iley/ghostchess/pcb/v1/README.md

# Ghost Chess v1 PCB

## Spreadsheets

Use https://github.com/TheJigsApp/kicad-parts-placer-pcm

Run `./convert-spreadsheet.sh watch`

Edit `kicadpartsplacer-report.ods` in LibreOffice.
