iley/ghostchess/parts.ods

Part | Type | Count | Status | Comment | Link
0.1uF cap 1206 | Capacitor | 131 | ordered | 129 for main board, 2 for brains
10uF cap 1206 | Capacitor | 2 | done
100uF 1206 | Capacitor | 1 | done
22pF 1206 | Capacitor | 2 | done
330 ohm 1206 | Resistor | 1 | done
10k ohm 1206 | Resistor | 10 | done | 8 for main board, 2 for brains
WS2812B | LED | 64 | done
DRV5033A | Sensor | 64 | done
SMBJ5.6A | Diode | 1 | ordered
MF-LSMF600 | Fuse | 1 | done
2N7002 | MOSFET | 8 | ordered
SS11-BBIWJ-R30-R | Switch | 1 | done | main power switch
AMS1117-3.3 | Linear regulator | 1 | ordered | 3.3v linear regulator
11.0592MHz HC49 | Crystal | 1 | ordered
12mm pushbutton | Pushbutton | 3 | done
Atmega 644p | MCU | 1 | done
ISP socket right-angle | Socket | 1 | done
DIP 40 socket | Socket | 1 | done
WC1602A | Screen | 1 | done |  | https://www.aliexpress.com/item/1005006034531826.html
