iley/ghostchess/pcb/proto/ghostchess_proto.step

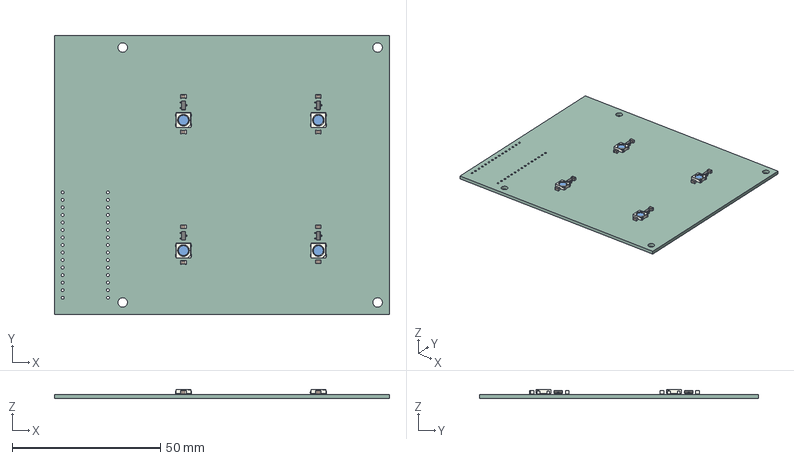
[picture p1: CAD file, 2026-04-05]
pcb/proto/ghostchess_proto.step
113.0 x 94.0 x 3.20 mm
C_0805_2012Metric x 8
SOT-23 x 4
LED_WS2812B_PLCC4_5.0x5.0mm_P3.2mm x 4
ghostchess_proto_PCB
