iley/ghostchess/(list of files, cad)

Other CAD files:
pcb/proto/autochess_proto.step
