iley/ghostchess/pcb/ghostchess_brains_v1/ghostchess_brains_v1.kicad_pcb

## KiCad design pcb/ghostchess_brains_v1/ghostchess_brains_v1.kicad_pcb (2026-08-10)

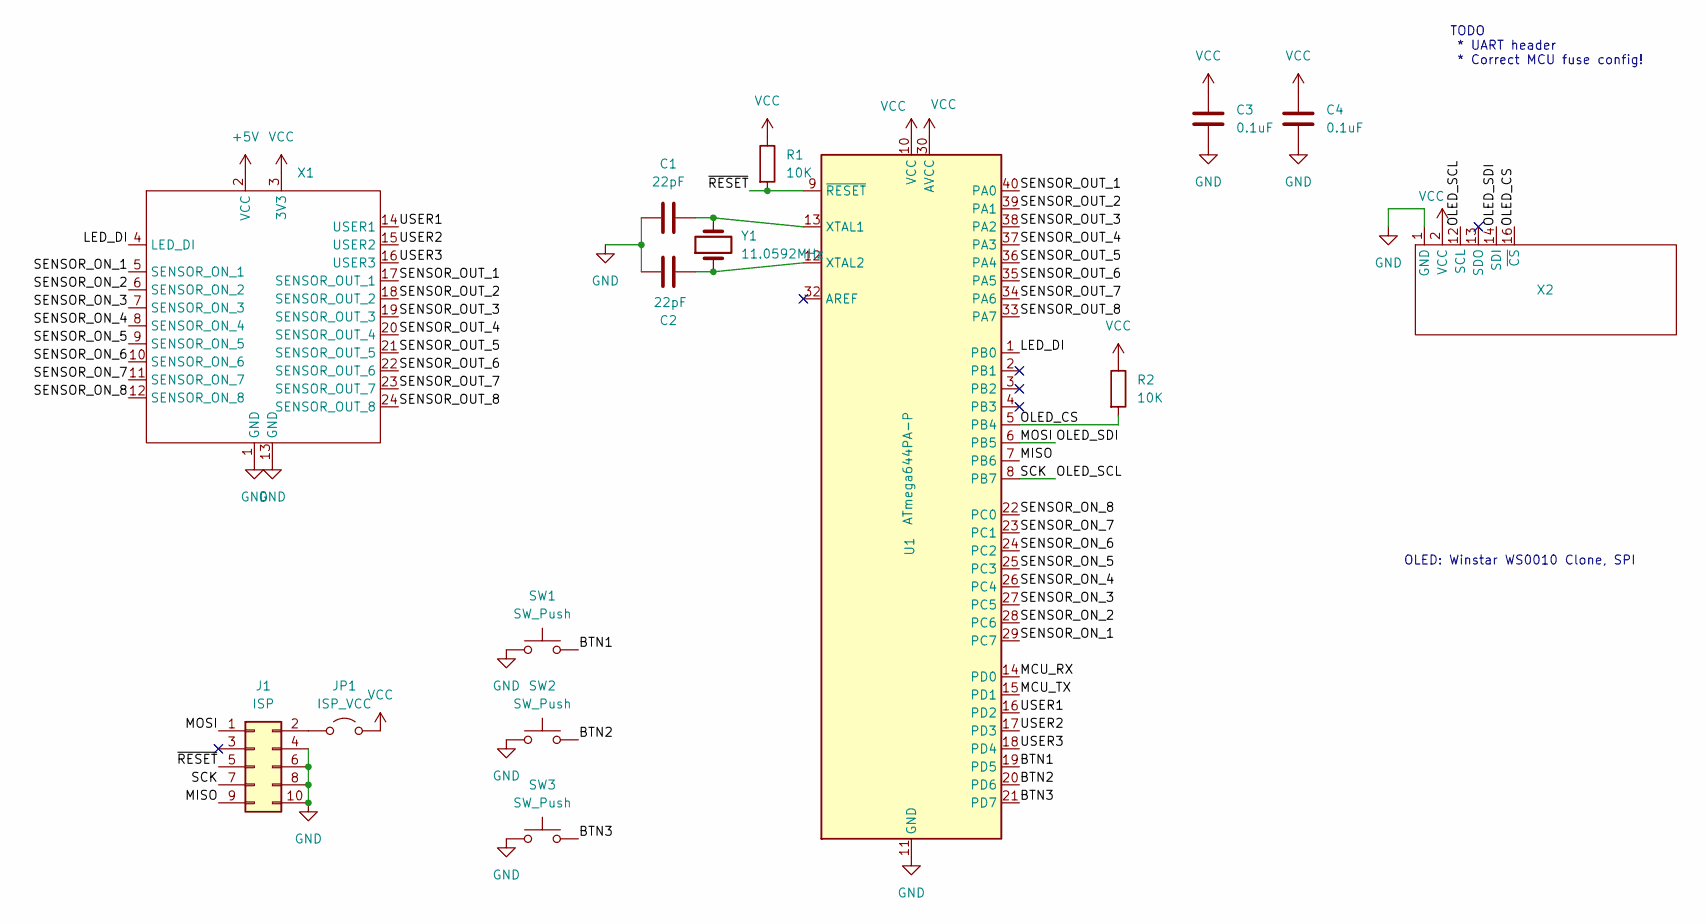
[picture p2: schematic ghostchess_brains_v1.kicad_sch]

Parts:
C1, C2: 22pF; C_1206_3216Metric_Pad1.33x1.80mm_HandSolder
C3, C4: 0.1uF; C_1206_3216Metric_Pad1.33x1.80mm_HandSolder
J1: ISP; IDC-Header_2x05_P2.54mm_Horizontal
JP1: ISP_VCC; PinHeader_1x02_P2.54mm_Vertical
R1, R2: 10K; C_1206_3216Metric_Pad1.33x1.80mm_HandSolder
SW1, SW2, SW3: SW_Push; SW_PUSH-12mm
U1: ATmega644PA-P; DIP-40_W15.24mm
X1: GhostChess_Daughter_Board
X2: WC1602A_3Hole
Y1: 11.0592MHz; Crystal_HC49-U_Vertical

Connections:
+5V: X1.2 (VCC)
/BTN1: SW1.2, U1.19 (PD5)
/BTN2: SW2.2, U1.20 (PD6)
/BTN3: SW3.2, U1.21 (PD7)
/LED_DI: U1.1 (PB0), X1.4 (LED_DI)
/MCU_RX: U1.14 (PD0)
/MCU_TX: U1.15 (PD1)
/MISO: J1.9, U1.7 (PB6)
/MOSI: J1.1, U1.6 (PB5), X2.14 (SDI)
/OLED_CS: R2.2, U1.5 (PB4), X2.16 (~CS)
/OLED_SCL: J1.7, U1.8 (PB7), X2.12 (SCL)
/SENSOR_ON_1: U1.29 (PC7), X1.5 (SENSOR_ON_1)
/SENSOR_ON_2: U1.28 (PC6), X1.6 (SENSOR_ON_2)
/SENSOR_ON_3: U1.27 (PC5), X1.7 (SENSOR_ON_3)
/SENSOR_ON_4: U1.26 (PC4), X1.8 (SENSOR_ON_4)
/SENSOR_ON_5: U1.25 (PC3), X1.9 (SENSOR_ON_5)
/SENSOR_ON_6: U1.24 (PC2), X1.10 (SENSOR_ON_6)
/SENSOR_ON_7: U1.23 (PC1), X1.11 (SENSOR_ON_7)
/SENSOR_ON_8: U1.22 (PC0), X1.12 (SENSOR_ON_8)
/SENSOR_OUT_1: U1.40 (PA0), X1.17 (SENSOR_OUT_1)
/SENSOR_OUT_2: U1.39 (PA1), X1.18 (SENSOR_OUT_2)
/SENSOR_OUT_3: U1.38 (PA2), X1.19 (SENSOR_OUT_3)
/SENSOR_OUT_4: U1.37 (PA3), X1.20 (SENSOR_OUT_4)
/SENSOR_OUT_5: U1.36 (PA4), X1.21 (SENSOR_OUT_5)
/SENSOR_OUT_6: U1.35 (PA5), X1.22 (SENSOR_OUT_6)
/SENSOR_OUT_7: U1.34 (PA6), X1.23 (SENSOR_OUT_7)
/SENSOR_OUT_8: U1.33 (PA7), X1.24 (SENSOR_OUT_8)
/USER1: U1.16 (PD2), X1.14 (USER1)
/USER2: U1.17 (PD3), X1.15 (USER2)
/USER3: U1.18 (PD4), X1.16 (USER3)
/~RESET: J1.5, R1.2, U1.9 (~RESET)
GND: C1.1, C2.1, C3.2, C4.2, J1.4, J1.6, J1.8, J1.10, SW1.1, SW2.1, SW3.1, U1.11 (GND), U1.31 (GND), X1.1 (GND), X1.13 (GND), X2.1 (GND)
unnamed: J1.2, JP1.1 (A)
unnamed: C1.2, U1.13 (XTAL1), Y1.2
unnamed: C2.2, U1.12 (XTAL2), Y1.1
VCC: C3.1, C4.1, JP1.2 (B), R1.1, R2.1, U1.10 (VCC), U1.30 (AVCC), X1.3 (3V3), X2.2 (VCC)

Notes on the sheet:
OLED: Winstar WS0010 Clone, SPI
TODO * UART header * Correct MCU fuse config!

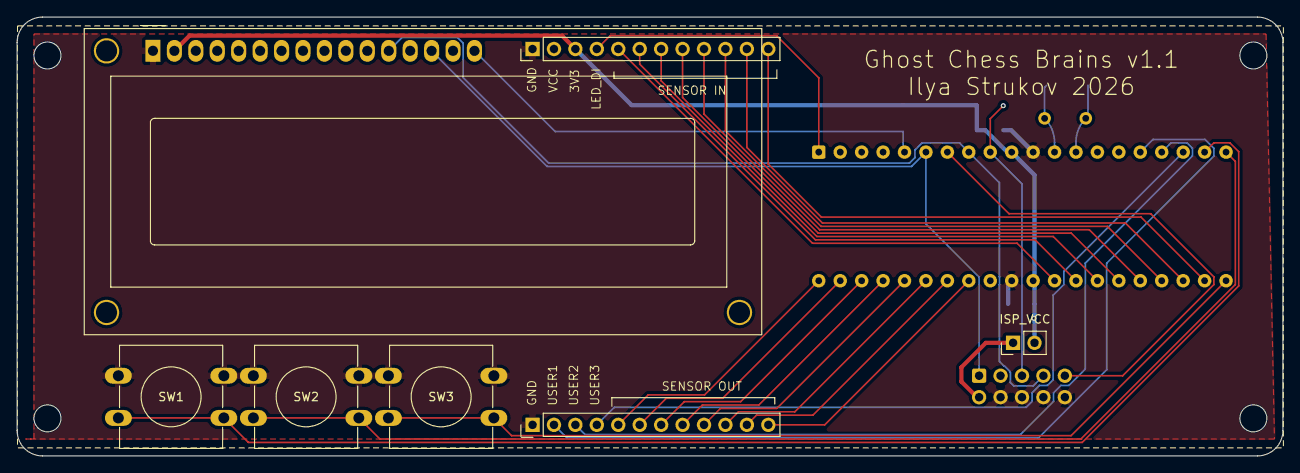
[picture p3: board ghostchess_brains_v1.kicad_pcb from above]

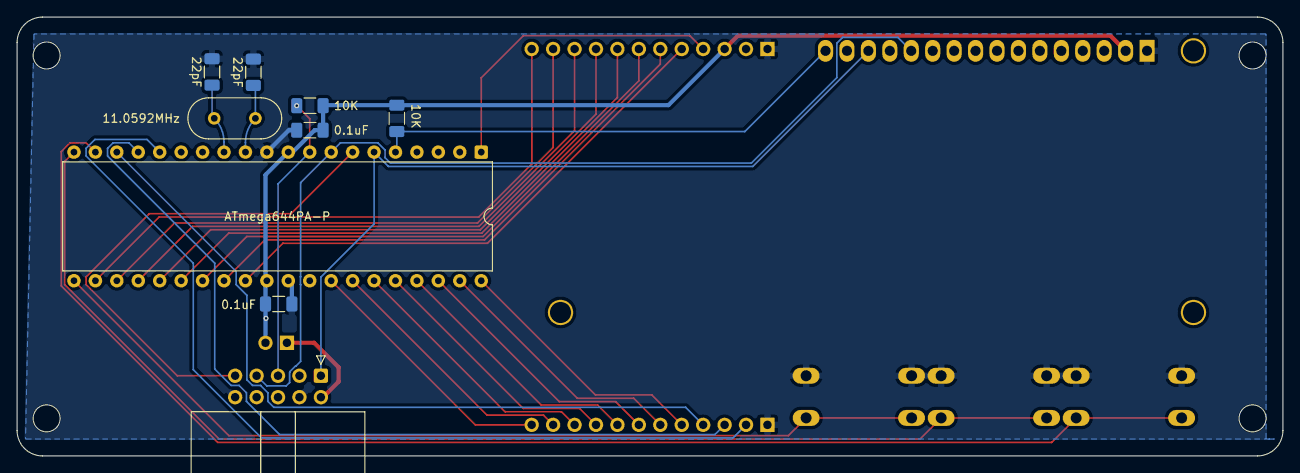
[picture p4: board ghostchess_brains_v1.kicad_pcb from below]

Board: 2 copper layers, 150.0 x 52.0 mm, 15 parts (9 on the bottom side), 33 nets.
