iley/ghostchess/pcb/v1/ghostchess_v1.kicad_pcb

## KiCad design pcb/v1/ghostchess_v1.kicad_pcb (2026-05-30)

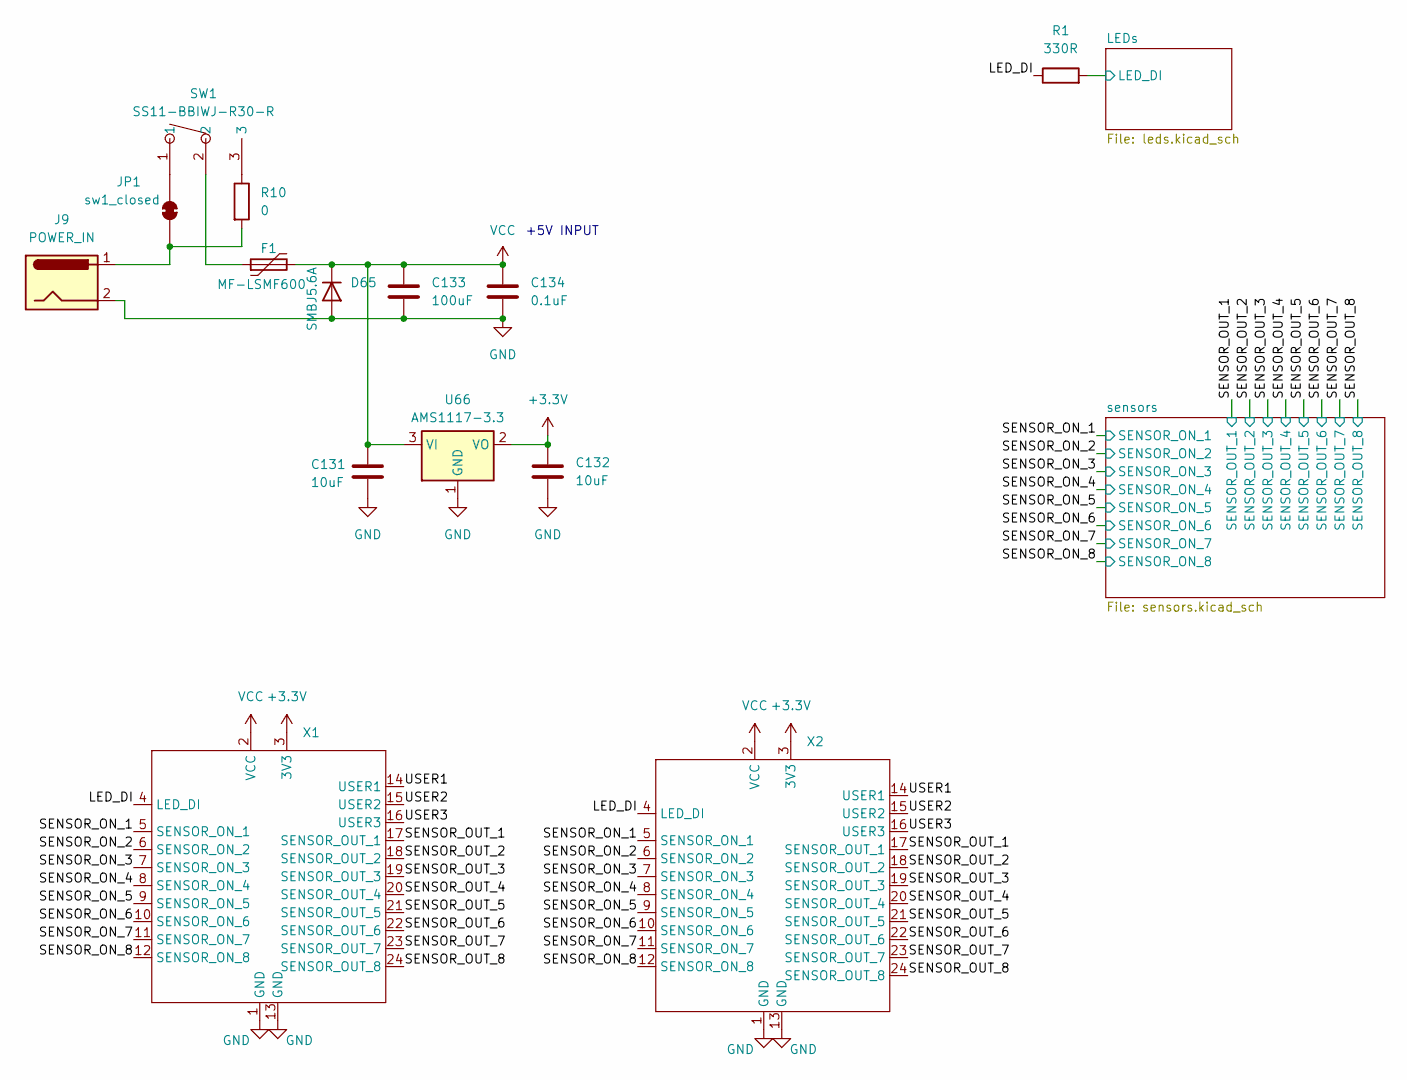
[picture p5: schematic ghostchess_v1.kicad_sch]

Parts:
C131, C132: 10uF; C_1206_3216Metric_Pad1.33x1.80mm_HandSolder
C133: 100uF; C_1206_3216Metric_Pad1.33x1.80mm_HandSolder
C134: 0.1uF; C_1206_3216Metric_Pad1.33x1.80mm_HandSolder
D65: SMBJ5.6A; D_SMB_Handsoldering
F1: MF-LSMF600; Fuse_2920_7451Metric_Pad2.10x5.45mm_HandSolder
J9: POWER_IN; BarrelJack_Horizontal
JP1: sw1_closed; SolderJumper-2_P1.3mm_Bridged_Pad1.0x1.5mm
R1: 330R; R_1206_3216Metric_Pad1.30x1.75mm_HandSolder
R10: 0; R_1206_3216Metric_Pad1.30x1.75mm_HandSolder
SW1: SS11-BBIWJ-R30-R; SW-TH_SS11-BBIWJ-R30-R; LCSC Part C309071
U66: AMS1117-3.3; SOT-223-3_TabPin2
X1, X2: GhostChess_Daughter_Board

Connections:
+3.3V: C132.1, U66.2 (VO), X1.3 (3V3), X2.3 (3V3); also elsewhere on the board
/LED_DI: R1.1, X1.4 (LED_DI), X2.4 (LED_DI)
/LEDs/LED_DI: R1.2; also elsewhere on the board
/SENSOR_ON_1: X1.5 (SENSOR_ON_1), X2.5 (SENSOR_ON_1); also elsewhere on the board
/SENSOR_ON_2: X1.6 (SENSOR_ON_2), X2.6 (SENSOR_ON_2); also elsewhere on the board
/SENSOR_ON_3: X1.7 (SENSOR_ON_3), X2.7 (SENSOR_ON_3); also elsewhere on the board
/SENSOR_ON_4: X1.8 (SENSOR_ON_4), X2.8 (SENSOR_ON_4); also elsewhere on the board
/SENSOR_ON_5: X1.9 (SENSOR_ON_5), X2.9 (SENSOR_ON_5); also elsewhere on the board
/SENSOR_ON_6: X1.10 (SENSOR_ON_6), X2.10 (SENSOR_ON_6); also elsewhere on the board
/SENSOR_ON_7: X1.11 (SENSOR_ON_7), X2.11 (SENSOR_ON_7); also elsewhere on the board
/SENSOR_ON_8: X1.12 (SENSOR_ON_8), X2.12 (SENSOR_ON_8); also elsewhere on the board
/SENSOR_OUT_1: X1.17 (SENSOR_OUT_1), X2.17 (SENSOR_OUT_1); also elsewhere on the board
/SENSOR_OUT_2: X1.18 (SENSOR_OUT_2), X2.18 (SENSOR_OUT_2); also elsewhere on the board
/SENSOR_OUT_3: X1.19 (SENSOR_OUT_3), X2.19 (SENSOR_OUT_3); also elsewhere on the board
/SENSOR_OUT_4: X1.20 (SENSOR_OUT_4), X2.20 (SENSOR_OUT_4); also elsewhere on the board
/SENSOR_OUT_5: X1.21 (SENSOR_OUT_5), X2.21 (SENSOR_OUT_5); also elsewhere on the board
/SENSOR_OUT_6: X1.22 (SENSOR_OUT_6), X2.22 (SENSOR_OUT_6); also elsewhere on the board
/SENSOR_OUT_7: X1.23 (SENSOR_OUT_7), X2.23 (SENSOR_OUT_7); also elsewhere on the board
/SENSOR_OUT_8: X1.24 (SENSOR_OUT_8), X2.24 (SENSOR_OUT_8); also elsewhere on the board
/USER1: X1.14 (USER1), X2.14 (USER1)
/USER2: X1.15 (USER2), X2.15 (USER2)
/USER3: X1.16 (USER3), X2.16 (USER3)
GND: C131.2, C132.2, C133.2, C134.2, D65.2 (A), J9.2, U66.1 (GND), X1.1 (GND), X1.13 (GND), X2.1 (GND), X2.13 (GND); also elsewhere on the board
unnamed: F1.1, SW1.2
unnamed: J9.1, JP1.1 (A), R10.2
unnamed: JP1.2 (B), SW1.1
unnamed: R10.1, SW1.3
VCC: C131.1, C133.1, C134.1, D65.1 (K), F1.2, U66.3 (VI), X1.2 (VCC), X2.2 (VCC); also elsewhere on the board

Notes on the sheet:
+5V INPUT

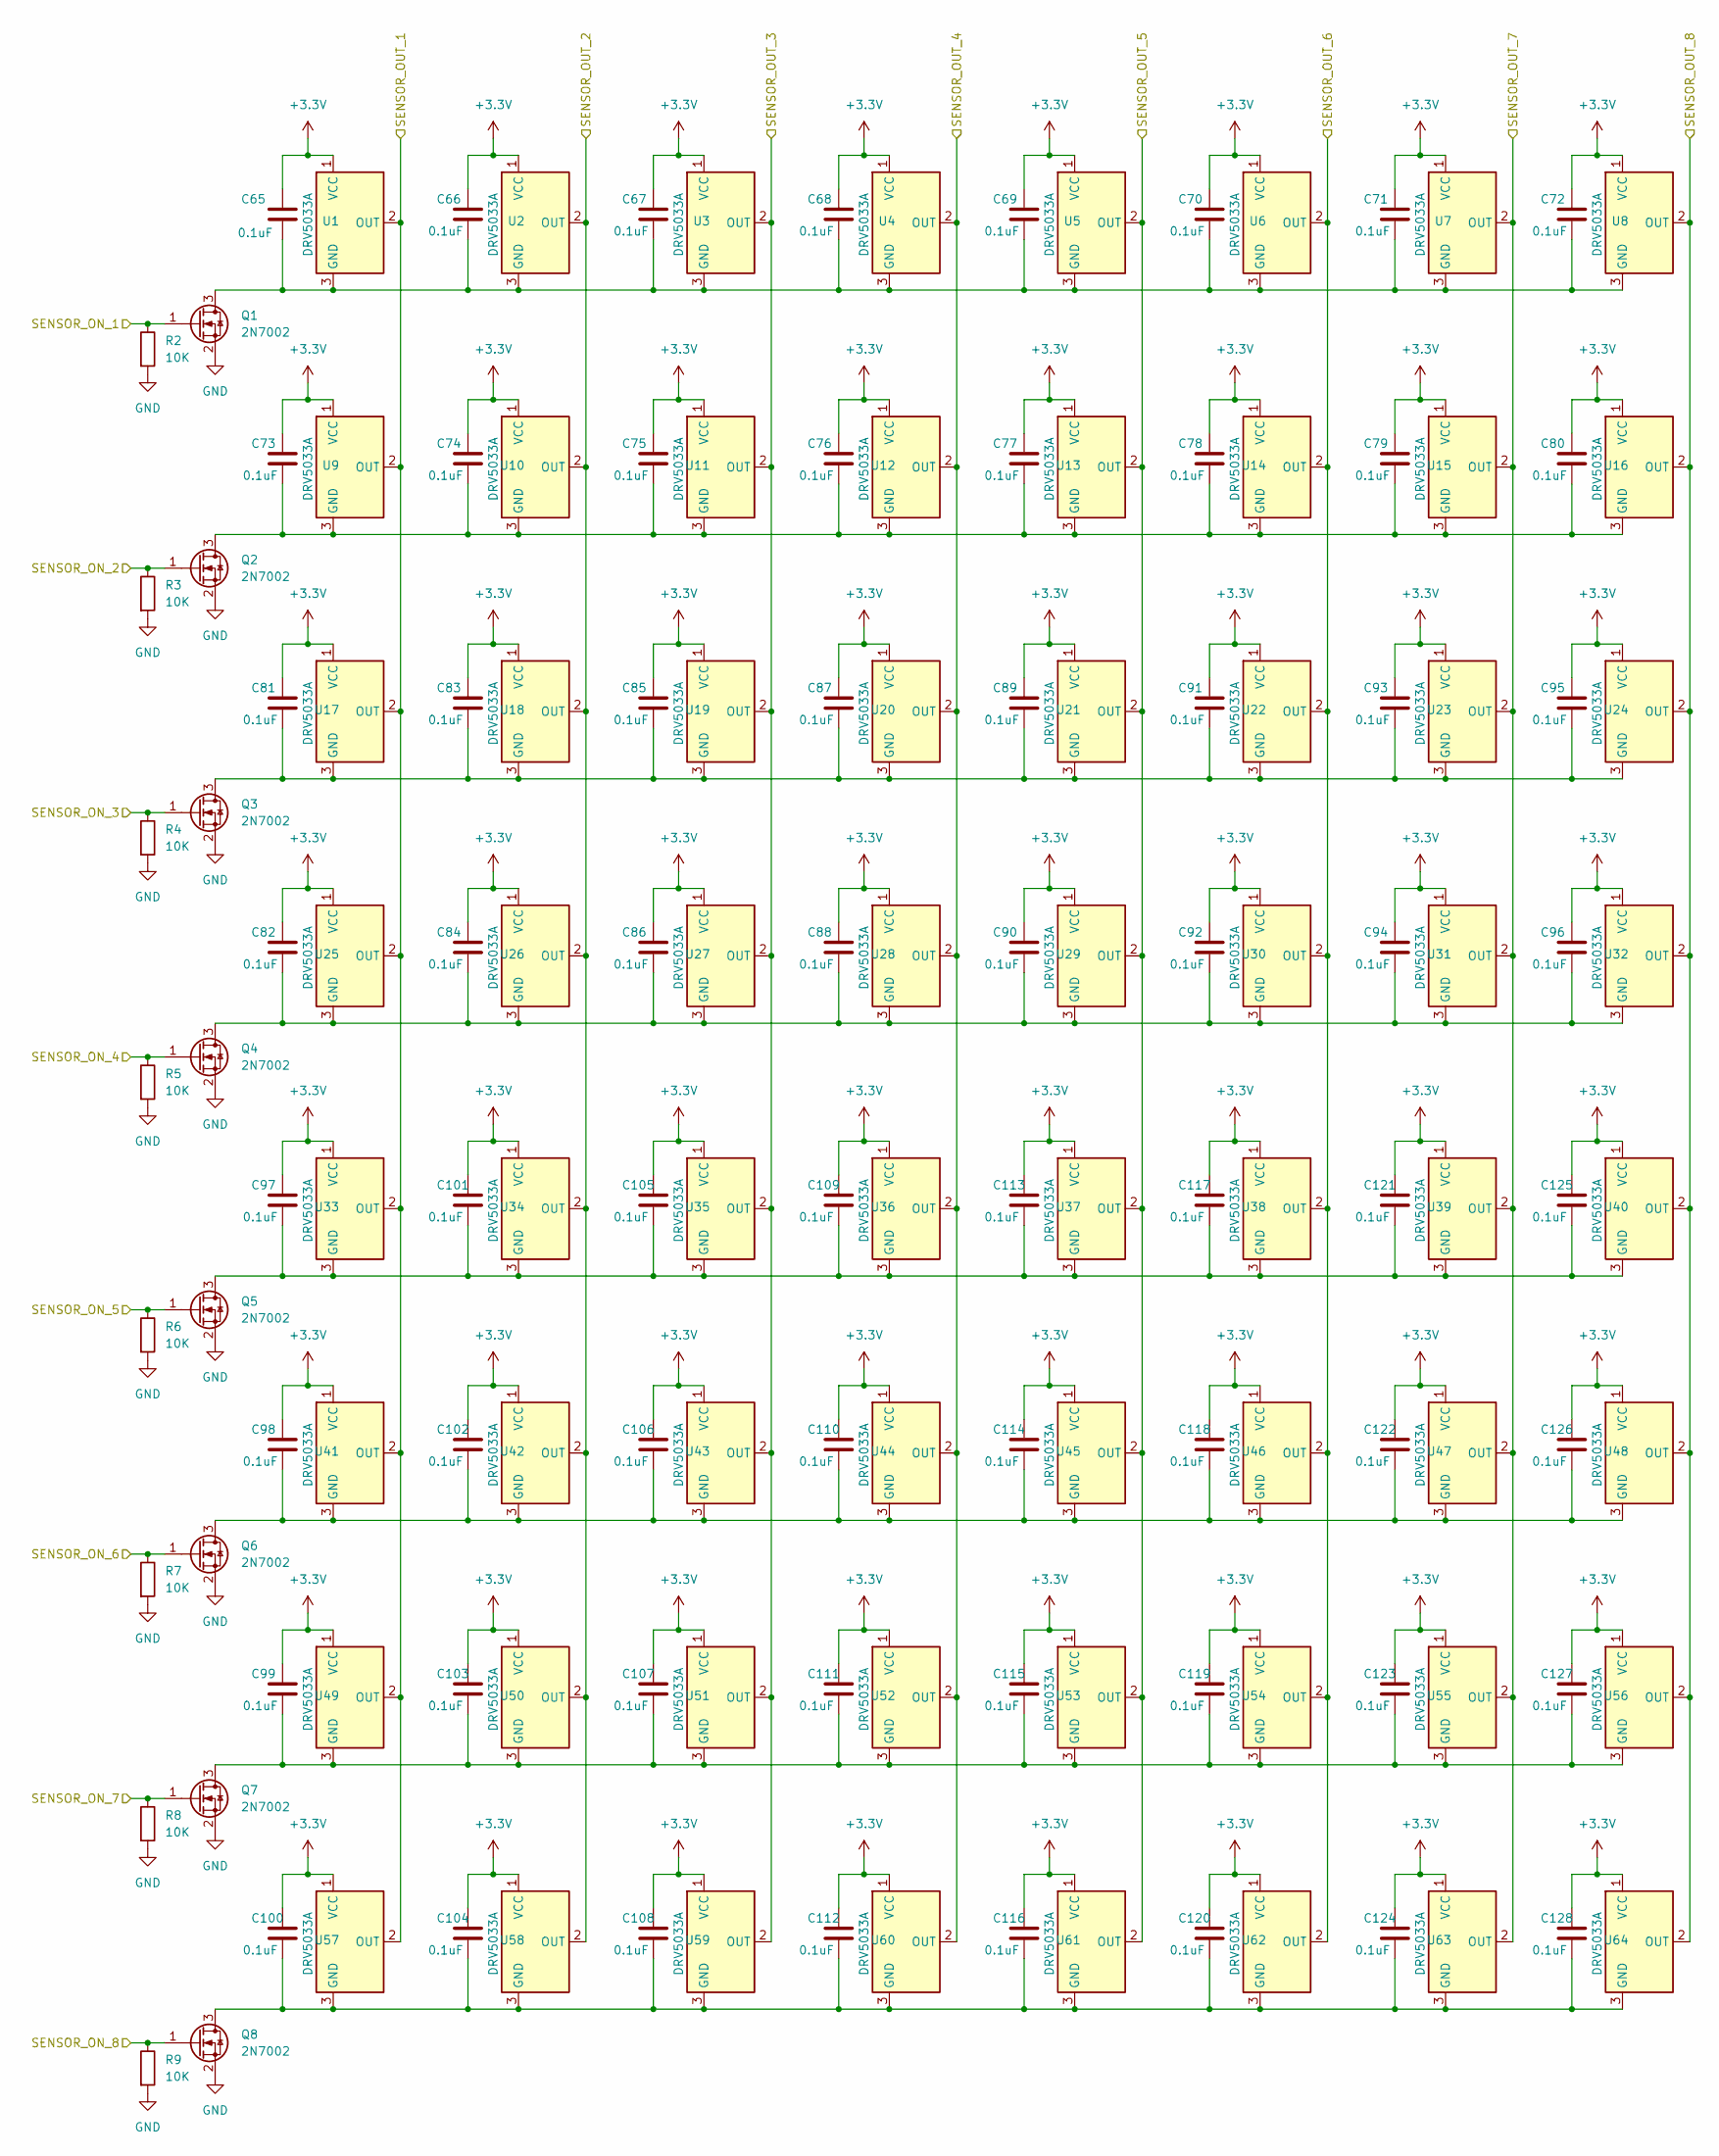
[picture p6: schematic sensors.kicad_sch]

Parts:
C65, C66, C67, C68, C69, C70, C71, C72, C73, C74, C75, C76, C77, C78, C79, C80, C81, C82, C83, C84, C85, C86, C87, C88, C89, C90, C91, C92, C93, C94, C95, C96, C97, C98, C99, C100, C101, C102, C103, C104, C105, C106, C107, C108, C109, C110, C111, C112, C113, C114, C115, C116, C117, C118, C119, C120, C121, C122, C123, C124, C125, C126, C127, C128: 0.1uF; C_1206_3216Metric_Pad1.33x1.80mm_HandSolder
Q1, Q2, Q3, Q4, Q5, Q6, Q7, Q8: 2N7002; SOT-23
R2, R3, R4, R5, R6, R7, R8, R9: 10K; R_1206_3216Metric_Pad1.30x1.75mm_HandSolder
U1, U2, U3, U4, U5, U6, U7, U8, U9, U10, U11, U12, U13, U14, U15, U16, U17, U18, U19, U20, U21, U22, U23, U24, U25, U26, U27, U28, U29, U30, U31, U32, U33, U34, U35, U36, U37, U38, U39, U40, U41, U42, U43, U44, U45, U46, U47, U48, U49, U50, U51, U52, U53, U54, U55, U56, U57, U58, U59, U60, U61, U62, U63, U64: DRV5033A; SOT-23

Connections:
+3.3V: C65.2, C66.1, C67.1, C68.1, C69.1, C70.1, C71.1, C72.1, C73.1, C74.1, C75.1, C76.1, C77.1, C78.1, C79.1, C80.1, C81.1, C82.1, C83.1, C84.1, C85.1, C86.1, C87.1, C88.1, C89.1, C90.1, C91.1, C92.1, C93.1, C94.1, C95.1, C96.1, C97.1, C98.1, C99.1, C100.1, C101.1, C102.1, C103.1, C104.1, C105.1, C106.1, C107.1, C108.1, C109.1, C110.1, C111.1, C112.1, C113.1, C114.1, C115.1, C116.1, C117.1, C118.1, C119.1, C120.1, C121.1, C122.1, C123.1, C124.1, C125.1, C126.1, C127.1, C128.1, U1.1 (VCC), U2.1 (VCC), U3.1 (VCC), U4.1 (VCC), U5.1 (VCC), U6.1 (VCC), U7.1 (VCC), U8.1 (VCC), U9.1 (VCC), U10.1 (VCC), U11.1 (VCC), U12.1 (VCC), U13.1 (VCC), U14.1 (VCC), U15.1 (VCC), U16.1 (VCC), U17.1 (VCC), U18.1 (VCC), U19.1 (VCC), U20.1 (VCC), U21.1 (VCC), U22.1 (VCC), U23.1 (VCC), U24.1 (VCC), U25.1 (VCC), U26.1 (VCC), U27.1 (VCC), U28.1 (VCC), U29.1 (VCC), U30.1 (VCC), U31.1 (VCC), U32.1 (VCC), U33.1 (VCC), U34.1 (VCC), U35.1 (VCC), U36.1 (VCC), U37.1 (VCC), U38.1 (VCC), U39.1 (VCC), U40.1 (VCC), U41.1 (VCC), U42.1 (VCC), U43.1 (VCC), U44.1 (VCC), U45.1 (VCC), U46.1 (VCC), U47.1 (VCC), U48.1 (VCC), U49.1 (VCC), U50.1 (VCC), U51.1 (VCC), U52.1 (VCC), U53.1 (VCC), U54.1 (VCC), U55.1 (VCC), U56.1 (VCC), U57.1 (VCC), U58.1 (VCC), U59.1 (VCC), U60.1 (VCC), U61.1 (VCC), U62.1 (VCC), U63.1 (VCC), U64.1 (VCC); also elsewhere on the board
/SENSOR_ON_1: Q1.1 (G), R2.1; also elsewhere on the board
/SENSOR_ON_2: Q2.1 (G), R3.1; also elsewhere on the board
/SENSOR_ON_3: Q3.1 (G), R4.1; also elsewhere on the board
/SENSOR_ON_4: Q4.1 (G), R5.1; also elsewhere on the board
/SENSOR_ON_5: Q5.1 (G), R6.1; also elsewhere on the board
/SENSOR_ON_6: Q6.1 (G), R7.1; also elsewhere on the board
/SENSOR_ON_7: Q7.1 (G), R8.1; also elsewhere on the board
/SENSOR_ON_8: Q8.1 (G), R9.1; also elsewhere on the board
/SENSOR_OUT_1: U1.2 (OUT), U9.2 (OUT), U17.2 (OUT), U25.2 (OUT), U33.2 (OUT), U41.2 (OUT), U49.2 (OUT), U57.2 (OUT); also elsewhere on the board
/SENSOR_OUT_2: U2.2 (OUT), U10.2 (OUT), U18.2 (OUT), U26.2 (OUT), U34.2 (OUT), U42.2 (OUT), U50.2 (OUT), U58.2 (OUT); also elsewhere on the board
/SENSOR_OUT_3: U3.2 (OUT), U11.2 (OUT), U19.2 (OUT), U27.2 (OUT), U35.2 (OUT), U43.2 (OUT), U51.2 (OUT), U59.2 (OUT); also elsewhere on the board
/SENSOR_OUT_4: U4.2 (OUT), U12.2 (OUT), U20.2 (OUT), U28.2 (OUT), U36.2 (OUT), U44.2 (OUT), U52.2 (OUT), U60.2 (OUT); also elsewhere on the board
/SENSOR_OUT_5: U5.2 (OUT), U13.2 (OUT), U21.2 (OUT), U29.2 (OUT), U37.2 (OUT), U45.2 (OUT), U53.2 (OUT), U61.2 (OUT); also elsewhere on the board
/SENSOR_OUT_6: U6.2 (OUT), U14.2 (OUT), U22.2 (OUT), U30.2 (OUT), U38.2 (OUT), U46.2 (OUT), U54.2 (OUT), U62.2 (OUT); also elsewhere on the board
/SENSOR_OUT_7: U7.2 (OUT), U15.2 (OUT), U23.2 (OUT), U31.2 (OUT), U39.2 (OUT), U47.2 (OUT), U55.2 (OUT), U63.2 (OUT); also elsewhere on the board
/SENSOR_OUT_8: U8.2 (OUT), U16.2 (OUT), U24.2 (OUT), U32.2 (OUT), U40.2 (OUT), U48.2 (OUT), U56.2 (OUT), U64.2 (OUT); also elsewhere on the board
GND: Q1.2 (S), Q2.2 (S), Q3.2 (S), Q4.2 (S), Q5.2 (S), Q6.2 (S), Q7.2 (S), Q8.2 (S), R2.2, R3.2, R4.2, R5.2, R6.2, R7.2, R8.2, R9.2; also elsewhere on the board
unnamed: C65.1, C66.2, C67.2, C68.2, C69.2, C70.2, C71.2, C72.2, Q1.3 (D), U1.3 (GND), U2.3 (GND), U3.3 (GND), U4.3 (GND), U5.3 (GND), U6.3 (GND), U7.3 (GND), U8.3 (GND)
unnamed: C73.2, C74.2, C75.2, C76.2, C77.2, C78.2, C79.2, C80.2, Q2.3 (D), U9.3 (GND), U10.3 (GND), U11.3 (GND), U12.3 (GND), U13.3 (GND), U14.3 (GND), U15.3 (GND), U16.3 (GND)
unnamed: C81.2, C83.2, C85.2, C87.2, C89.2, C91.2, C93.2, C95.2, Q3.3 (D), U17.3 (GND), U18.3 (GND), U19.3 (GND), U20.3 (GND), U21.3 (GND), U22.3 (GND), U23.3 (GND), U24.3 (GND)
unnamed: C82.2, C84.2, C86.2, C88.2, C90.2, C92.2, C94.2, C96.2, Q4.3 (D), U25.3 (GND), U26.3 (GND), U27.3 (GND), U28.3 (GND), U29.3 (GND), U30.3 (GND), U31.3 (GND), U32.3 (GND)
unnamed: C97.2, C101.2, C105.2, C109.2, C113.2, C117.2, C121.2, C125.2, Q5.3 (D), U33.3 (GND), U34.3 (GND), U35.3 (GND), U36.3 (GND), U37.3 (GND), U38.3 (GND), U39.3 (GND), U40.3 (GND)
unnamed: C98.2, C102.2, C106.2, C110.2, C114.2, C118.2, C122.2, C126.2, Q6.3 (D), U41.3 (GND), U42.3 (GND), U43.3 (GND), U44.3 (GND), U45.3 (GND), U46.3 (GND), U47.3 (GND), U48.3 (GND)
unnamed: C99.2, C103.2, C107.2, C111.2, C115.2, C119.2, C123.2, C127.2, Q7.3 (D), U49.3 (GND), U50.3 (GND), U51.3 (GND), U52.3 (GND), U53.3 (GND), U54.3 (GND), U55.3 (GND), U56.3 (GND)
unnamed: C100.2, C104.2, C108.2, C112.2, C116.2, C120.2, C124.2, C128.2, Q8.3 (D), U57.3 (GND), U58.3 (GND), U59.3 (GND), U60.3 (GND), U61.3 (GND), U62.3 (GND), U63.3 (GND), U64.3 (GND)

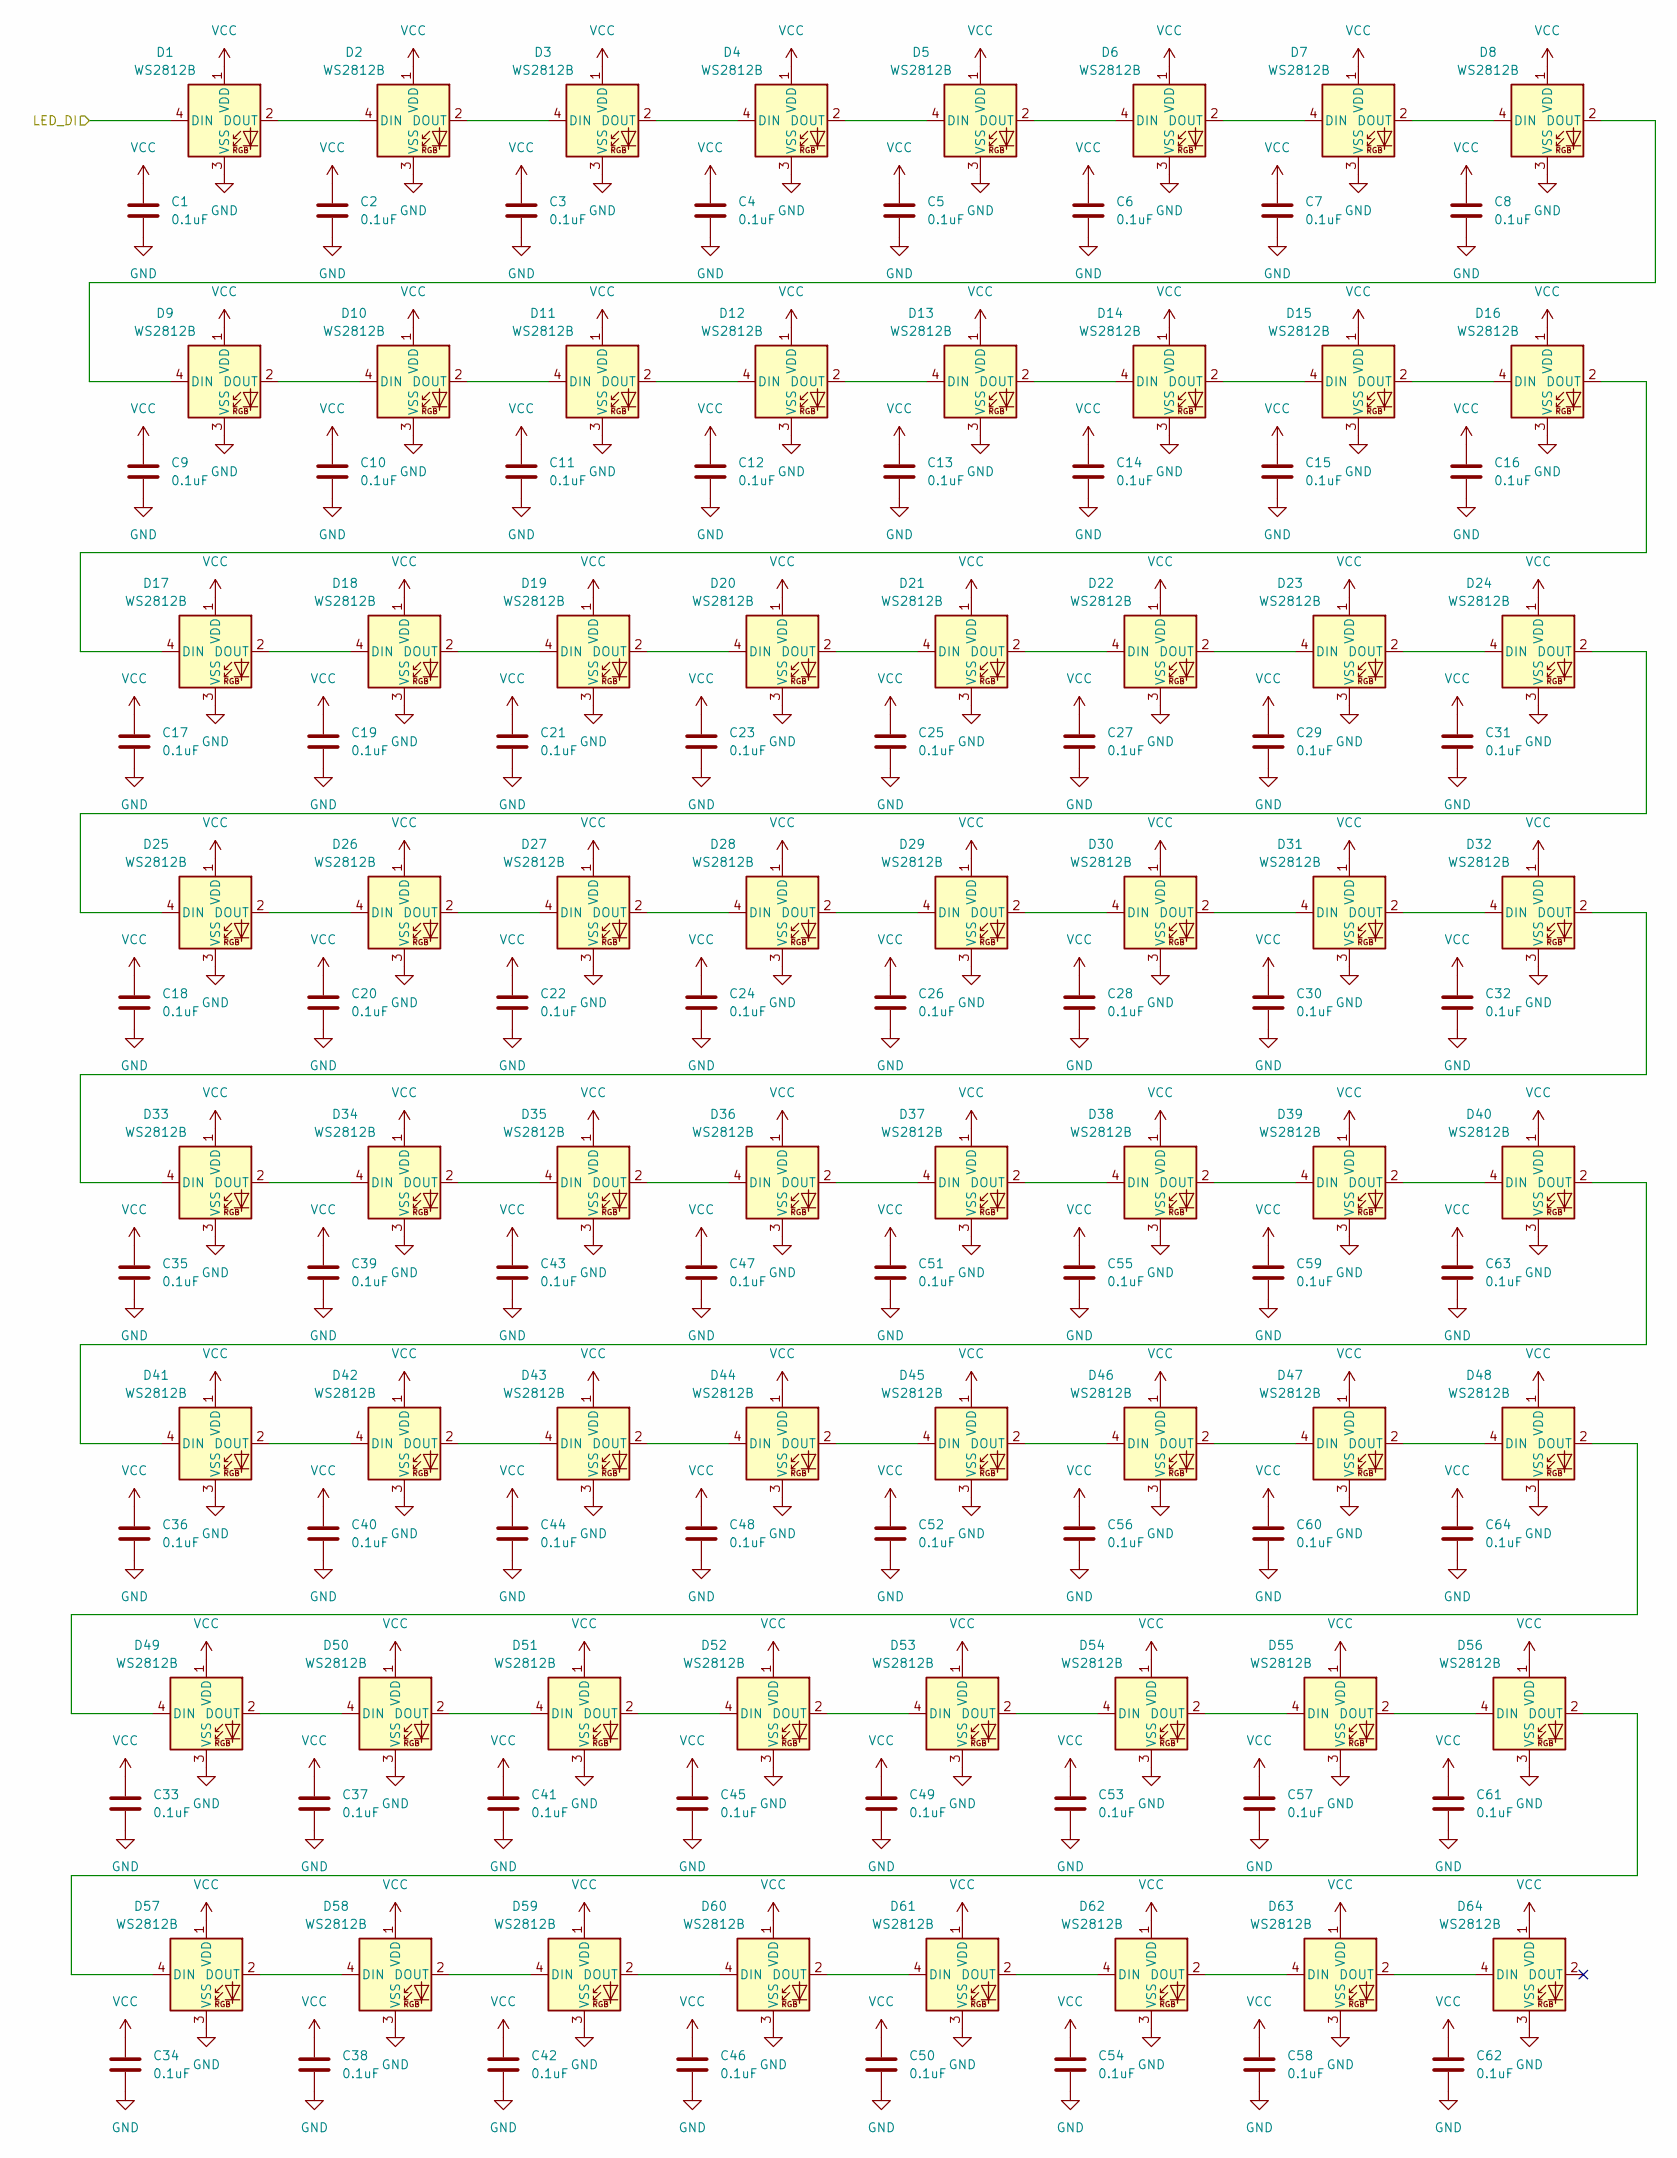
[picture p7: schematic leds.kicad_sch]

Parts:
C1, C2, C3, C4, C5, C6, C7, C8, C9, C10, C11, C12, C13, C14, C15, C16, C17, C18, C19, C20, C21, C22, C23, C24, C25, C26, C27, C28, C29, C30, C31, C32, C33, C34, C35, C36, C37, C38, C39, C40, C41, C42, C43, C44, C45, C46, C47, C48, C49, C50, C51, C52, C53, C54, C55, C56, C57, C58, C59, C60, C61, C62, C63, C64: 0.1uF; C_1206_3216Metric_Pad1.33x1.80mm_HandSolder
D1, D2, D3, D4, D5, D6, D7, D8, D9, D10, D11, D12, D13, D14, D15, D16, D17, D18, D19, D20, D21, D22, D23, D24, D25, D26, D27, D28, D29, D30, D31, D32, D33, D34, D35, D36, D37, D38, D39, D40, D41, D42, D43, D44, D45, D46, D47, D48, D49, D50, D51, D52, D53, D54, D55, D56, D57, D58, D59, D60, D61, D62, D63, D64: WS2812B; LED_WS2812B_PLCC4_5.0x5.0mm_P3.2mm

Connections:
/LEDs/LED_DI: D1.4 (DIN); also elsewhere on the board
GND: C1.2, C2.2, C3.2, C4.2, C5.2, C6.2, C7.2, C8.2, C9.2, C10.2, C11.2, C12.2, C13.2, C14.2, C15.2, C16.2, C17.2, C18.2, C19.2, C20.2, C21.2, C22.2, C23.2, C24.2, C25.2, C26.2, C27.2, C28.2, C29.2, C30.2, C31.2, C32.2, C33.2, C34.2, C35.2, C36.2, C37.2, C38.2, C39.2, C40.2, C41.2, C42.2, C43.2, C44.2, C45.2, C46.2, C47.2, C48.2, C49.2, C50.2, C51.2, C52.2, C53.2, C54.2, C55.2, C56.2, C57.2, C58.2, C59.2, C60.2, C61.2, C62.2, C63.2, C64.2, D1.3 (VSS), D2.3 (VSS), D3.3 (VSS), D4.3 (VSS), D5.3 (VSS), D6.3 (VSS), D7.3 (VSS), D8.3 (VSS), D9.3 (VSS), D10.3 (VSS), D11.3 (VSS), D12.3 (VSS), D13.3 (VSS), D14.3 (VSS), D15.3 (VSS), D16.3 (VSS), D17.3 (VSS), D18.3 (VSS), D19.3 (VSS), D20.3 (VSS), D21.3 (VSS), D22.3 (VSS), D23.3 (VSS), D24.3 (VSS), D25.3 (VSS), D26.3 (VSS), D27.3 (VSS), D28.3 (VSS), D29.3 (VSS), D30.3 (VSS), D31.3 (VSS), D32.3 (VSS), D33.3 (VSS), D34.3 (VSS), D35.3 (VSS), D36.3 (VSS), D37.3 (VSS), D38.3 (VSS), D39.3 (VSS), D40.3 (VSS), D41.3 (VSS), D42.3 (VSS), D43.3 (VSS), D44.3 (VSS), D45.3 (VSS), D46.3 (VSS), D47.3 (VSS), D48.3 (VSS), D49.3 (VSS), D50.3 (VSS), D51.3 (VSS), D52.3 (VSS), D53.3 (VSS), D54.3 (VSS), D55.3 (VSS), D56.3 (VSS), D57.3 (VSS), D58.3 (VSS), D59.3 (VSS), D60.3 (VSS), D61.3 (VSS), D62.3 (VSS), D63.3 (VSS), D64.3 (VSS); also elsewhere on the board
unnamed: D1.2 (DOUT), D2.4 (DIN)
unnamed: D2.2 (DOUT), D3.4 (DIN)
unnamed: D3.2 (DOUT), D4.4 (DIN)
unnamed: D4.2 (DOUT), D5.4 (DIN)
unnamed: D5.2 (DOUT), D6.4 (DIN)
unnamed: D6.2 (DOUT), D7.4 (DIN)
unnamed: D7.2 (DOUT), D8.4 (DIN)
unnamed: D8.2 (DOUT), D9.4 (DIN)
unnamed: D9.2 (DOUT), D10.4 (DIN)
unnamed: D10.2 (DOUT), D11.4 (DIN)
unnamed: D11.2 (DOUT), D12.4 (DIN)
unnamed: D12.2 (DOUT), D13.4 (DIN)
unnamed: D13.2 (DOUT), D14.4 (DIN)
unnamed: D14.2 (DOUT), D15.4 (DIN)
unnamed: D15.2 (DOUT), D16.4 (DIN)
unnamed: D16.2 (DOUT), D17.4 (DIN)
unnamed: D17.2 (DOUT), D18.4 (DIN)
unnamed: D18.2 (DOUT), D19.4 (DIN)
unnamed: D19.2 (DOUT), D20.4 (DIN)
unnamed: D20.2 (DOUT), D21.4 (DIN)
unnamed: D21.2 (DOUT), D22.4 (DIN)
unnamed: D22.2 (DOUT), D23.4 (DIN)
unnamed: D23.2 (DOUT), D24.4 (DIN)
unnamed: D24.2 (DOUT), D25.4 (DIN)
unnamed: D25.2 (DOUT), D26.4 (DIN)
unnamed: D26.2 (DOUT), D27.4 (DIN)
unnamed: D27.2 (DOUT), D28.4 (DIN)
unnamed: D28.2 (DOUT), D29.4 (DIN)
unnamed: D29.2 (DOUT), D30.4 (DIN)
unnamed: D30.2 (DOUT), D31.4 (DIN)
unnamed: D31.2 (DOUT), D32.4 (DIN)
unnamed: D32.2 (DOUT), D33.4 (DIN)
unnamed: D33.2 (DOUT), D34.4 (DIN)
unnamed: D34.2 (DOUT), D35.4 (DIN)
unnamed: D35.2 (DOUT), D36.4 (DIN)
unnamed: D36.2 (DOUT), D37.4 (DIN)
unnamed: D37.2 (DOUT), D38.4 (DIN)
unnamed: D38.2 (DOUT), D39.4 (DIN)
unnamed: D39.2 (DOUT), D40.4 (DIN)
unnamed: D40.2 (DOUT), D41.4 (DIN)
unnamed: D41.2 (DOUT), D42.4 (DIN)
unnamed: D42.2 (DOUT), D43.4 (DIN)
unnamed: D43.2 (DOUT), D44.4 (DIN)
unnamed: D44.2 (DOUT), D45.4 (DIN)
unnamed: D45.2 (DOUT), D46.4 (DIN)
unnamed: D46.2 (DOUT), D47.4 (DIN)
unnamed: D47.2 (DOUT), D48.4 (DIN)
unnamed: D48.2 (DOUT), D49.4 (DIN)
unnamed: D49.2 (DOUT), D50.4 (DIN)
unnamed: D50.2 (DOUT), D51.4 (DIN)
unnamed: D51.2 (DOUT), D52.4 (DIN)
unnamed: D52.2 (DOUT), D53.4 (DIN)
unnamed: D53.2 (DOUT), D54.4 (DIN)
unnamed: D54.2 (DOUT), D55.4 (DIN)
unnamed: D55.2 (DOUT), D56.4 (DIN)
unnamed: D56.2 (DOUT), D57.4 (DIN)
unnamed: D57.2 (DOUT), D58.4 (DIN)
unnamed: D58.2 (DOUT), D59.4 (DIN)
unnamed: D59.2 (DOUT), D60.4 (DIN)
unnamed: D60.2 (DOUT), D61.4 (DIN)
unnamed: D61.2 (DOUT), D62.4 (DIN)
unnamed: D62.2 (DOUT), D63.4 (DIN)
unnamed: D63.2 (DOUT), D64.4 (DIN)
VCC: C1.1, C2.1, C3.1, C4.1, C5.1, C6.1, C7.1, C8.1, C9.1, C10.1, C11.1, C12.1, C13.1, C14.1, C15.1, C16.1, C17.1, C18.1, C19.1, C20.1, C21.1, C22.1, C23.1, C24.1, C25.1, C26.1, C27.1, C28.1, C29.1, C30.1, C31.1, C32.1, C33.1, C34.1, C35.1, C36.1, C37.1, C38.1, C39.1, C40.1, C41.1, C42.1, C43.1, C44.1, C45.1, C46.1, C47.1, C48.1, C49.1, C50.1, C51.1, C52.1, C53.1, C54.1, C55.1, C56.1, C57.1, C58.1, C59.1, C60.1, C61.1, C62.1, C63.1, C64.1, D1.1 (VDD), D2.1 (VDD), D3.1 (VDD), D4.1 (VDD), D5.1 (VDD), D6.1 (VDD), D7.1 (VDD), D8.1 (VDD), D9.1 (VDD), D10.1 (VDD), D11.1 (VDD), D12.1 (VDD), D13.1 (VDD), D14.1 (VDD), D15.1 (VDD), D16.1 (VDD), D17.1 (VDD), D18.1 (VDD), D19.1 (VDD), D20.1 (VDD), D21.1 (VDD), D22.1 (VDD), D23.1 (VDD), D24.1 (VDD), D25.1 (VDD), D26.1 (VDD), D27.1 (VDD), D28.1 (VDD), D29.1 (VDD), D30.1 (VDD), D31.1 (VDD), D32.1 (VDD), D33.1 (VDD), D34.1 (VDD), D35.1 (VDD), D36.1 (VDD), D37.1 (VDD), D38.1 (VDD), D39.1 (VDD), D40.1 (VDD), D41.1 (VDD), D42.1 (VDD), D43.1 (VDD), D44.1 (VDD), D45.1 (VDD), D46.1 (VDD), D47.1 (VDD), D48.1 (VDD), D49.1 (VDD), D50.1 (VDD), D51.1 (VDD), D52.1 (VDD), D53.1 (VDD), D54.1 (VDD), D55.1 (VDD), D56.1 (VDD), D57.1 (VDD), D58.1 (VDD), D59.1 (VDD), D60.1 (VDD), D61.1 (VDD), D62.1 (VDD), D63.1 (VDD), D64.1 (VDD); also elsewhere on the board

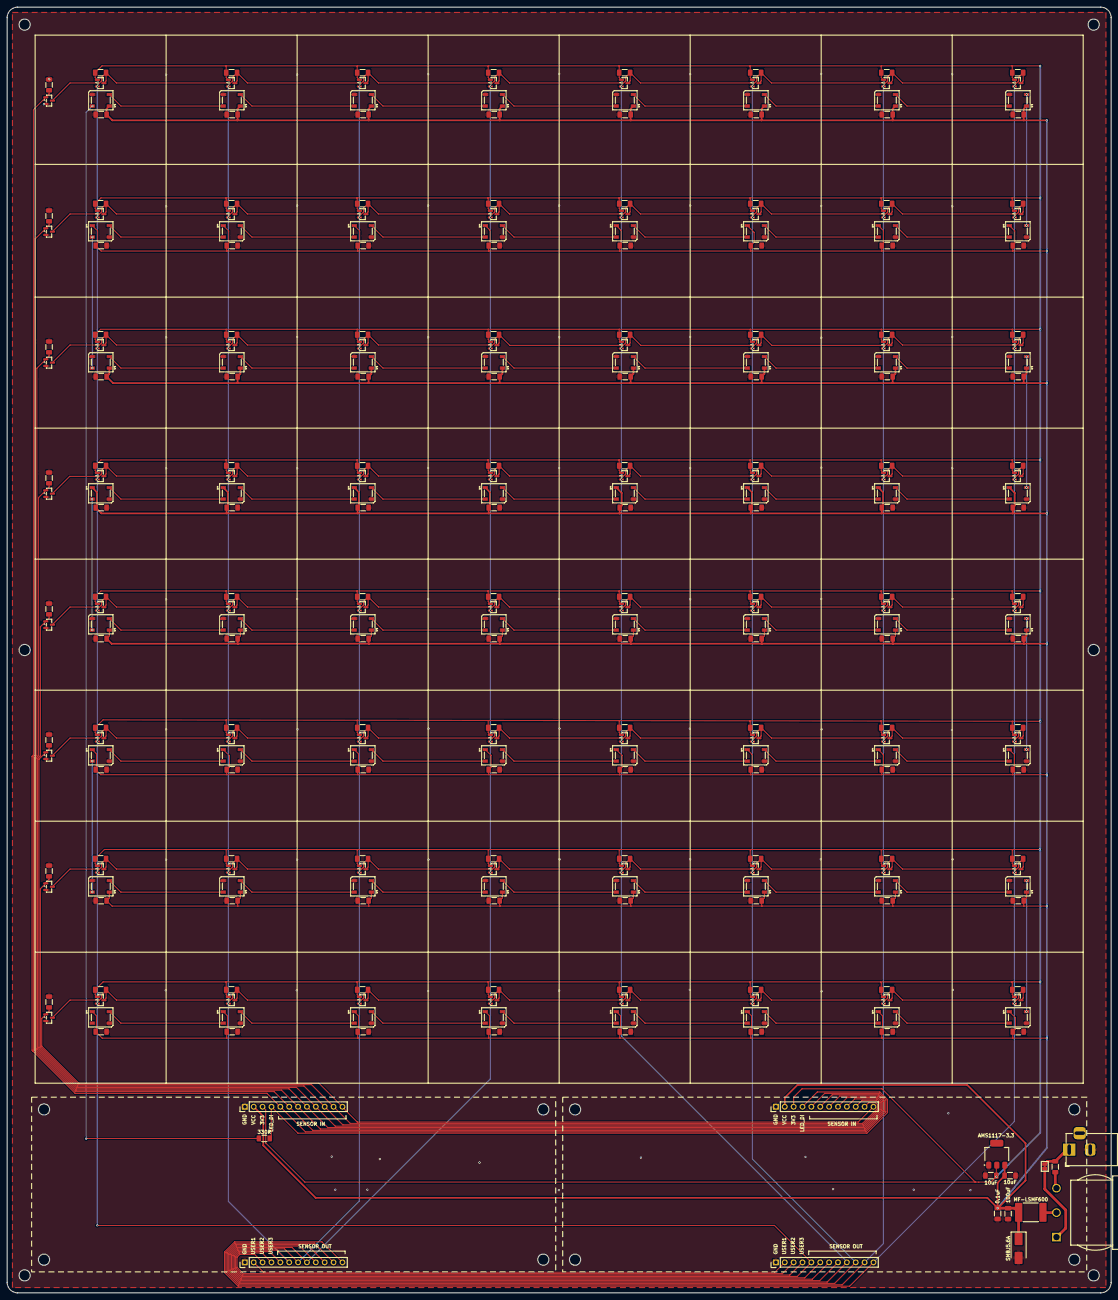
[picture p8: board ghostchess_v1.kicad_pcb from above]

Board: 2 copper layers, 316.0 x 368.0 mm, 286 parts (0 on the bottom side), 99 nets.
