iley/ghostchess/pcb/proto/ghostchess_proto.kicad_pcb

## KiCad design pcb/proto/ghostchess_proto.kicad_pcb (2026-04-05)

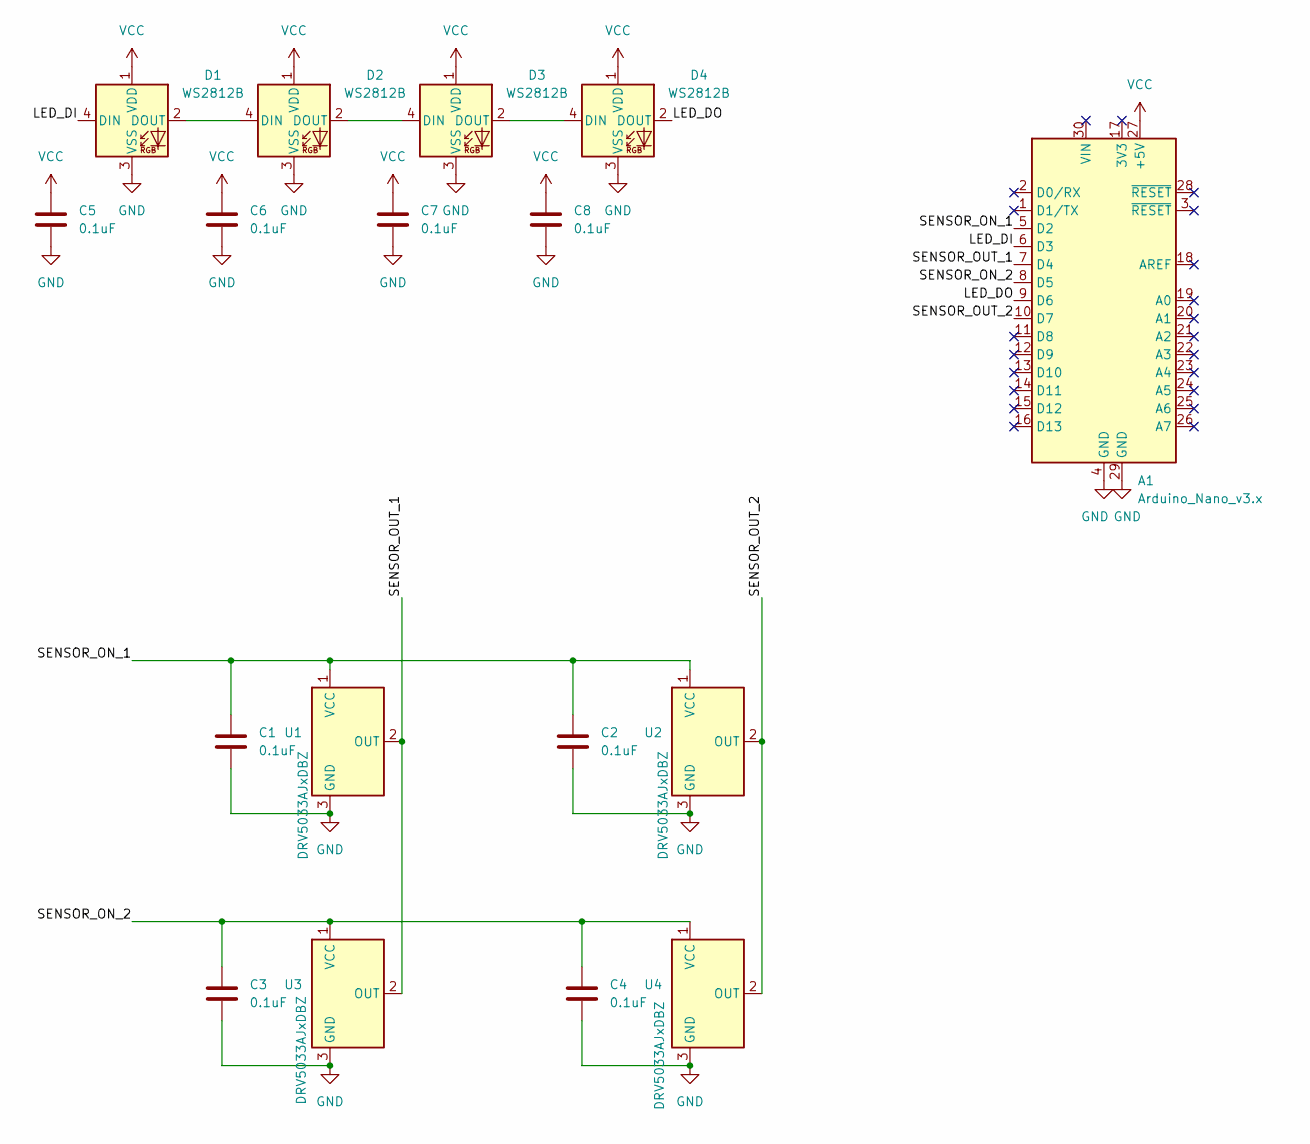
[picture p9: schematic ghostchess_proto.kicad_sch]

Parts:
A1: Arduino_Nano_v3.x; Arduino_Nano
C1, C2, C3, C4, C5, C6, C7, C8: 0.1uF; C_0805_2012Metric_Pad1.18x1.45mm_HandSolder
D1, D2, D3, D4: WS2812B; LED_WS2812B_PLCC4_5.0x5.0mm_P3.2mm
U1, U2, U3, U4: DRV5033AJxDBZ; SOT-23

Connections:
/LED_DI: A1.6 (D3), D1.4 (DIN)
/LED_DO: A1.9 (D6), D4.2 (DOUT)
/SENSOR_ON_1: A1.5 (D2), C1.1, C2.1, U1.1 (VCC), U2.1 (VCC)
/SENSOR_ON_2: A1.8 (D5), C3.1, C4.1, U3.1 (VCC), U4.1 (VCC)
/SENSOR_OUT_1: A1.7 (D4), U1.2 (OUT), U3.2 (OUT)
/SENSOR_OUT_2: A1.10 (D7), U2.2 (OUT), U4.2 (OUT)
GND: A1.4 (GND), A1.29 (GND), C1.2, C2.2, C3.2, C4.2, C5.2, C6.2, C7.2, C8.2, D1.3 (VSS), D2.3 (VSS), D3.3 (VSS), D4.3 (VSS), U1.3 (GND), U2.3 (GND), U3.3 (GND), U4.3 (GND)
unnamed: D1.2 (DOUT), D2.4 (DIN)
unnamed: D2.2 (DOUT), D3.4 (DIN)
unnamed: D3.2 (DOUT), D4.4 (DIN)
VCC: A1.27 (+5V), C5.1, C6.1, C7.1, C8.1, D1.1 (VDD), D2.1 (VDD), D3.1 (VDD), D4.1 (VDD)

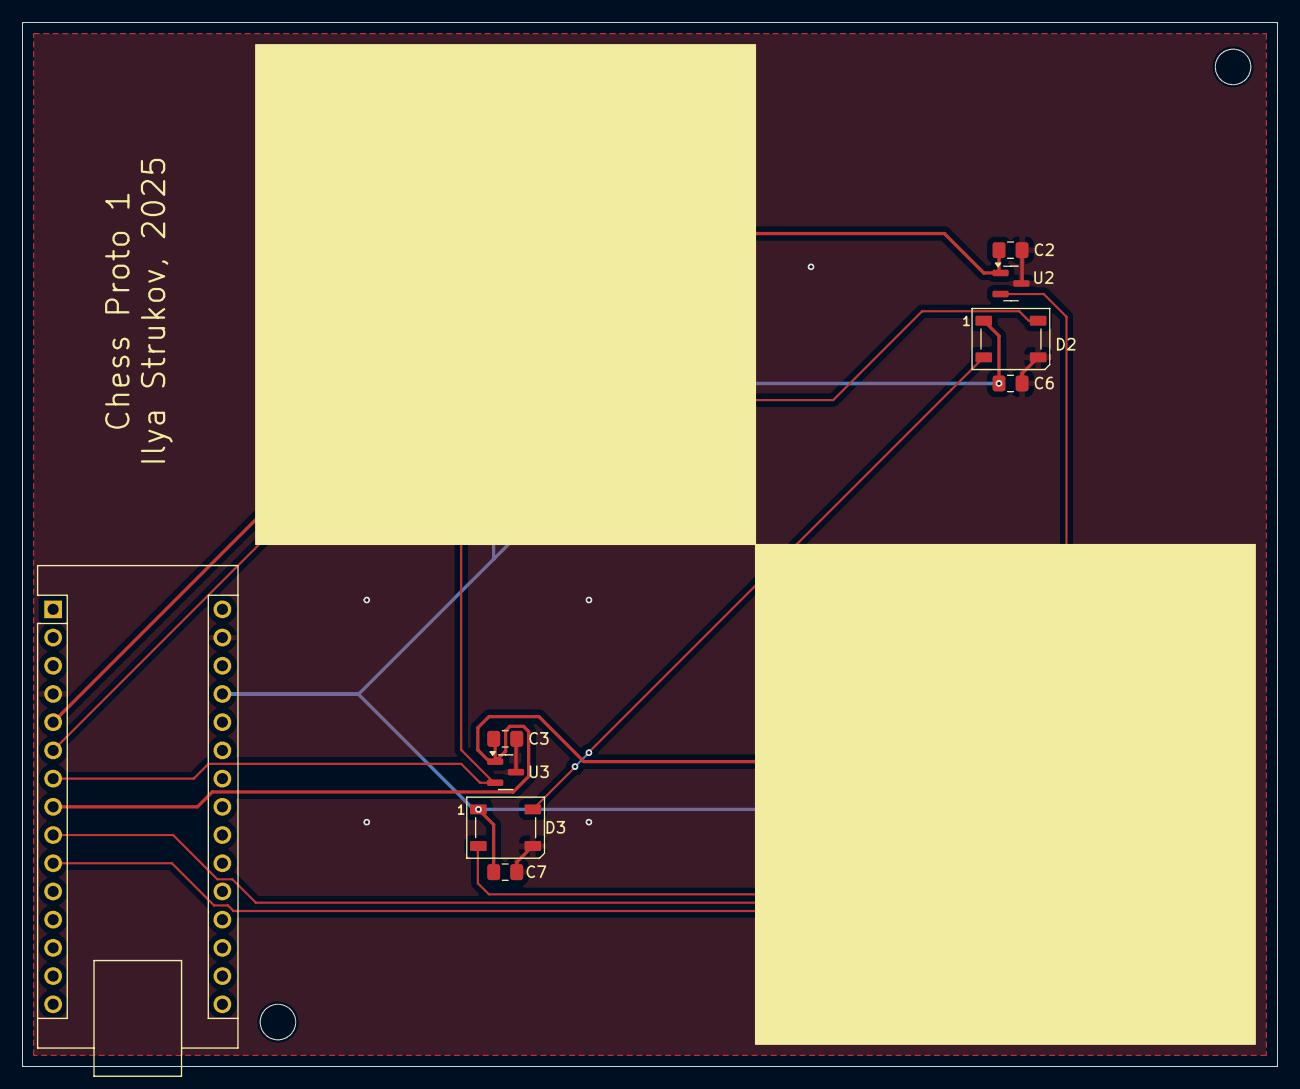
[picture p10: board ghostchess_proto.kicad_pcb from above]

Board: 2 copper layers, 113.0 x 94.0 mm, 17 parts (0 on the bottom side), 11 nets.
