iley/ghostchess/(commit log)

2023-07-09 PCB: first attempt
    [autochess.kicad_pcb, autochess.kicad_sch]
2023-07-09 PCB layout: second attempt
    [autochess.kicad_pcb, autochess.kicad_sch]
2024-11-26 Move older PCB into a subdirectory
    [autochess.kicad_pcb, autochess.kicad_sch]
2024-11-29 Start proto1 PCB design
    [autochess_proto1.kicad_pcb, autochess_proto1.kicad_sch]
2025-03-29 Proto PCB 1
    [autochess_proto.kicad_pcb, autochess_proto.kicad_sch]
2025-04-27 Final changes in the Proto PCB
    [autochess_proto.kicad_pcb, autochess_proto.step]
2025-04-27 Proximity sensor test
2025-05-11 LEDs demo
2025-12-25 Make some progress on the PCB
    [autochess_v1.kicad_sch, sensors.kicad_sch]
2025-12-25 Update the proto PCB
2026-02-16 Finish the schematic draft, start pcb layout
    [BOM.ods, autochess_v1.kicad_pcb, autochess_v1.kicad_sch, leds.kicad_sch, sensors.kicad_sch]
2026-02-18 Misc. PCB changes
    [autochess_v1.kicad_pcb]
2026-02-21 Continue laying out the PCB
    [autochess_v1.kicad_pcb, autochess_v1.kicad_sch, leds.kicad_sch, sensors.kicad_sch]
2026-03-21 Update to KiCAD 10.0
    [autochess_v1.kicad_pcb, autochess_v1.kicad_sch, leds.kicad_sch, sensors.kicad_sch]
2026-04-04 Continue layout
    [autochess_v1.kicad_pcb]
2026-04-04 Spreasheet-driven layout
    [autochess_v1.kicad_pcb, kicadpartsplacer-report.csv, kicadpartsplacer-report.ods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]
2026-04-04 Continue placing component
    [autochess_v1.kicad_pcb, kicadpartsplacer-report.csv, kicadpartsplacer-report.ods]
2026-04-04 Continue placing
    [autochess_v1.kicad_sch, sensors.kicad_sch]
2026-04-04 Place most components
    [autochess_v1.kicad_pcb, autochess_v1.kicad_sch, kicadpartsplacer-report.csv, kicadpartsplacer-report.ods, sensors.kicad_sch]
2026-04-05 Continue PCB layout
    [autochess_v1.kicad_pcb, autochess_v1.kicad_sch, kicadpartsplacer-report.csv, kicadpartsplacer-report.ods]
2026-04-05 Add stuff
    [autochess_v1.kicad_sch]
2026-04-05 On-off switch 3d model
    [ghostchess_v1.kicad_pcb]
2026-04-05 Add daughter board symbol
    [ghostchess_v1.kicad_pcb, ghostchess_v1.kicad_sch]
2026-04-05 Daughterboard footprints, more layout work
    [ghostchess_v1.kicad_pcb, ghostchess_v1.kicad_sch]
2026-04-05 Add logo
    [ghostchess_v1.kicad_pcb]
2026-05-10 More layout
    [ghostchess_v1.kicad_pcb, kicadpartsplacer-report.csv, kicadpartsplacer-report.ods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]
2026-05-10 Fix DRC
    [ghostchess_v1.kicad_pcb]
2026-05-30 Order the board
    [ghostchess_v1.kicad_pcb]
2026-06-13 brains pcb start
    [ghostchess_brains_v1.kicad_pcb, ghostchess_brains_v1.kicad_sch]
2026-06-13 Make progress on the brains PCB
    [ghostchess_brains_v1.kicad_pcb, ghostchess_brains_v1.kicad_sch]
2026-06-14 Start routing
    [ghostchess_brains_v1.kicad_pcb, ghostchess_brains_v1.kicad_sch]
2026-06-27 brains v1 board
    [ghostchess_brains_v1.kicad_pcb, ghostchess_brains_v1.kicad_sch]
2026-07-04 Add parts spreadsheet
    [parts.ods]
2026-07-12 update parts
    [parts.ods]
2026-08-09 pcb: connect LED data to ATmega PB0
    [ghostchess_brains_v1.kicad_pcb, ghostchess_brains_v1.kicad_sch]
2026-08-09 firmware: add initial board scanner
2026-08-10 Brains v1.1
    [ghostchess_brains_v1.kicad_pcb, ghostchess_brains_v1.kicad_sch]
2026-08-10 OLED driver
2026-09-07 Minor PCB tweak
2026-10-06 Fix OLED clear timing and simplify firmware gesture state
    [assistant.c, assistant.h, main.c, oled.c]
